GroanKing05/AudioAmplifier/Hardware Oscilloscope Images/Bandpass and Voltage Regulators.jpg

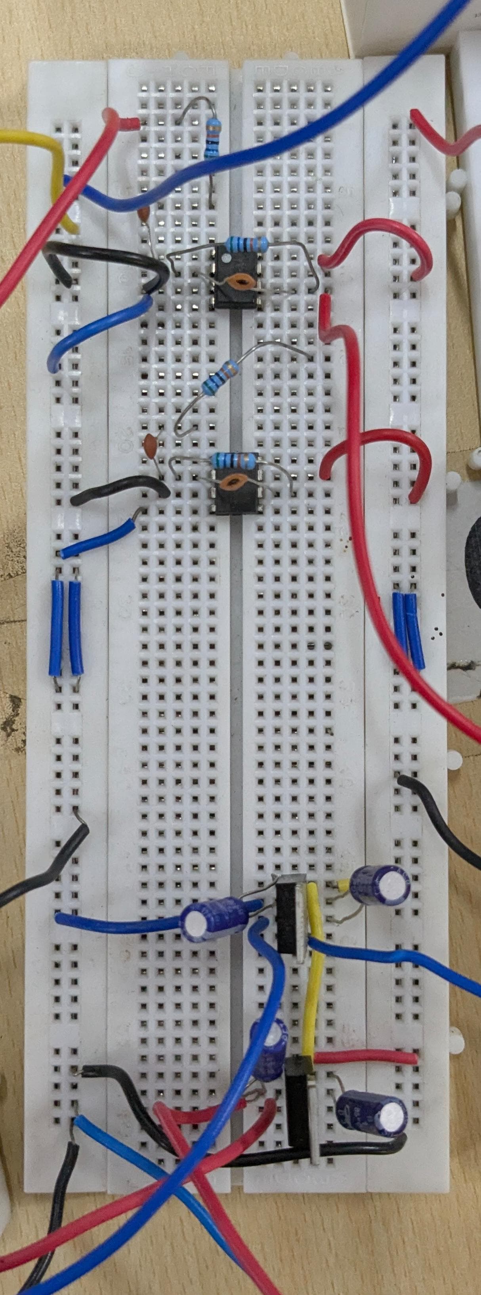
Hardware Oscilloscope Images/Bandpass and Voltage Regulators.jpg
