GroanKing05/AudioAmplifier/Hardware Oscilloscope Images/BP 3dB.png

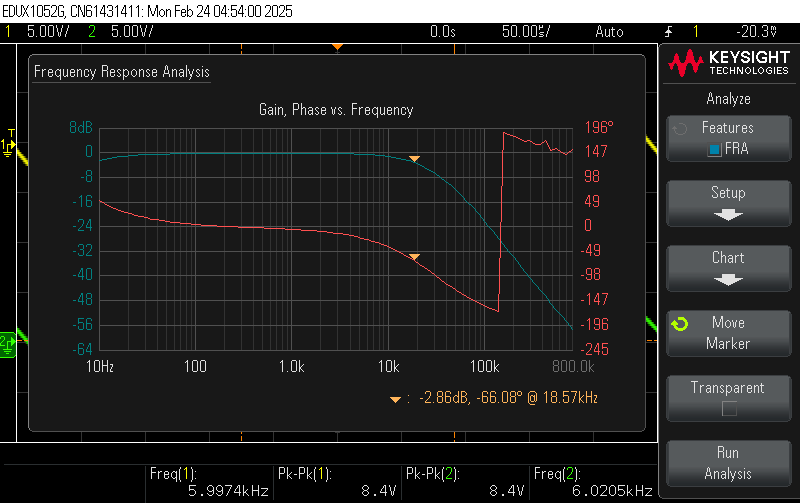
Hardware Oscilloscope Images/BP 3dB.png
