GroanKing05/AudioAmplifier/Hardware Oscilloscope Images/BP midband.png

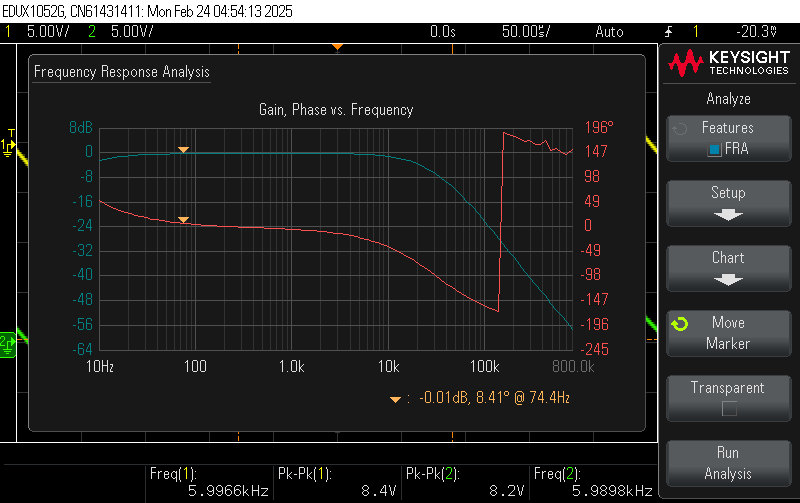
Hardware Oscilloscope Images/BP midband.png
