GroanKing05/AudioAmplifier/Hardware Oscilloscope Images/FFT 1k4k.png

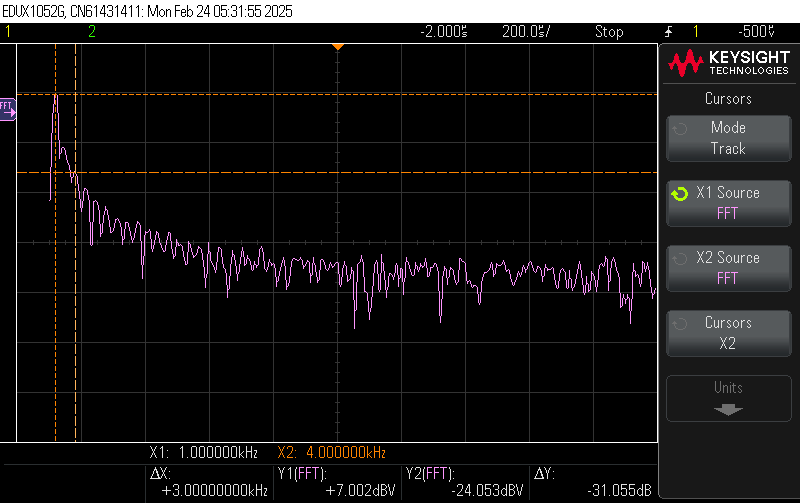
Hardware Oscilloscope Images/FFT 1k4k.png
