GroanKing05/AudioAmplifier/Hardware Oscilloscope Images/FFT with Voltages.png

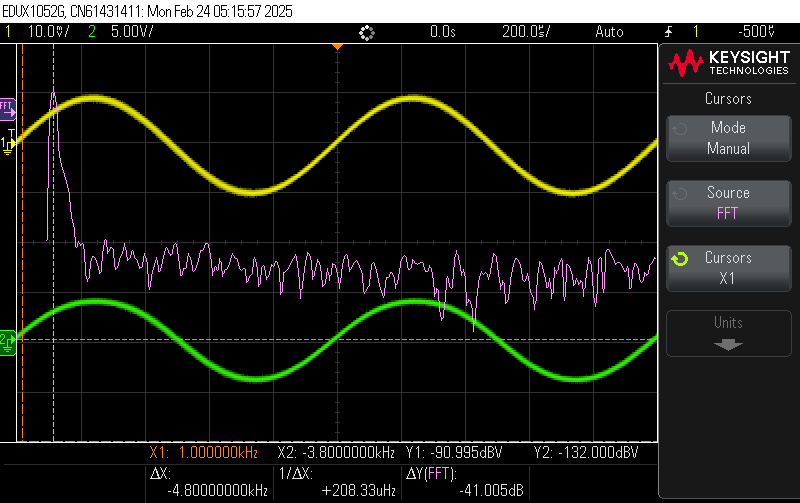
Hardware Oscilloscope Images/FFT with Voltages.png
