GroanKing05/AudioAmplifier/Hardware Oscilloscope Images/Final Bode Midband.png

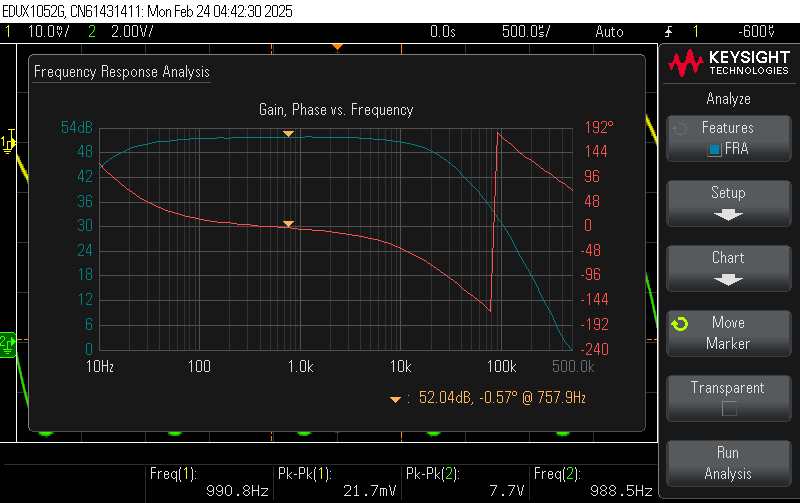
Hardware Oscilloscope Images/Final Bode Midband.png
