GroanKing05/AudioAmplifier/Hardware Oscilloscope Images/Final Voltages.png

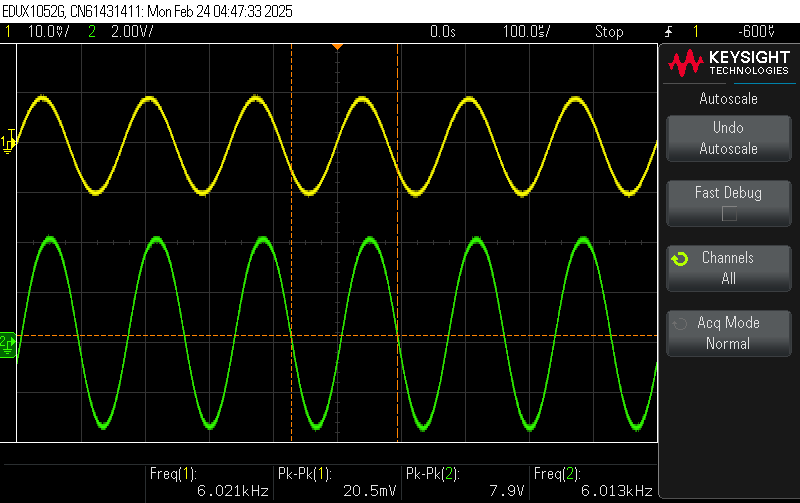
Hardware Oscilloscope Images/Final Voltages.png
