GroanKing05/AudioAmplifier/Hardware Oscilloscope Images/FinalBode Higher3db.png

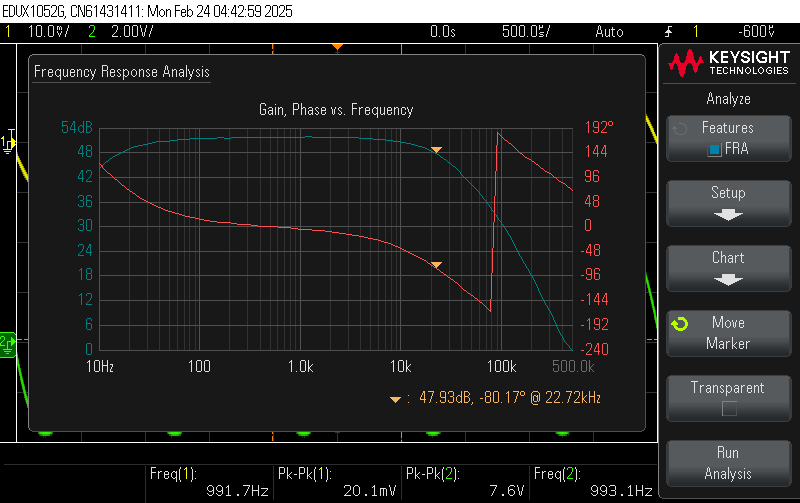
Hardware Oscilloscope Images/FinalBode Higher3db.png
