GroanKing05/AudioAmplifier/Hardware Oscilloscope Images/Full Voltages.png

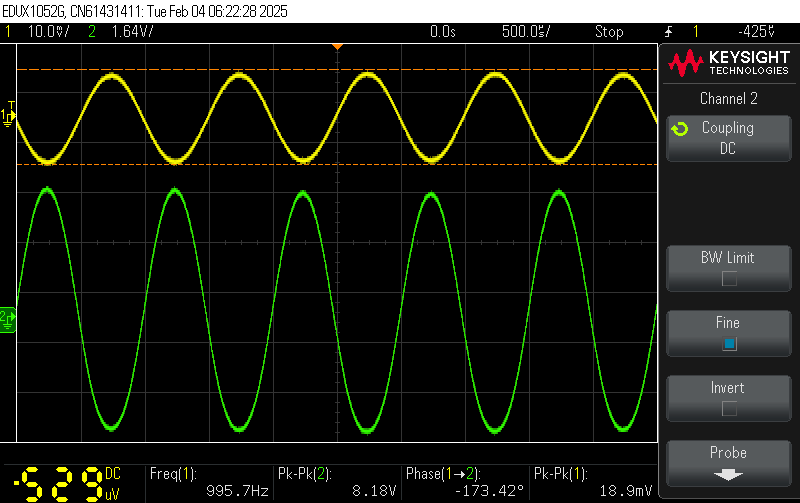
Hardware Oscilloscope Images/Full Voltages.png
