GroanKing05/AudioAmplifier/Hardware Oscilloscope Images/Labelled BP VoltageRegs.png

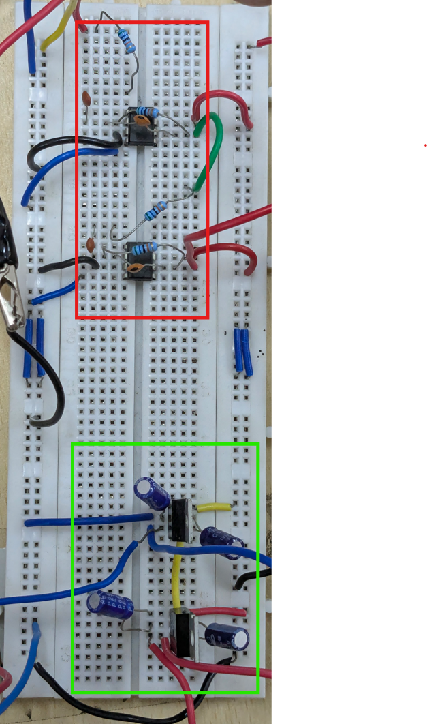
Hardware Oscilloscope Images/Labelled BP VoltageRegs.png
