GroanKing05/AudioAmplifier/Hardware Oscilloscope Images/Labelled Gain Preamp Amp.png

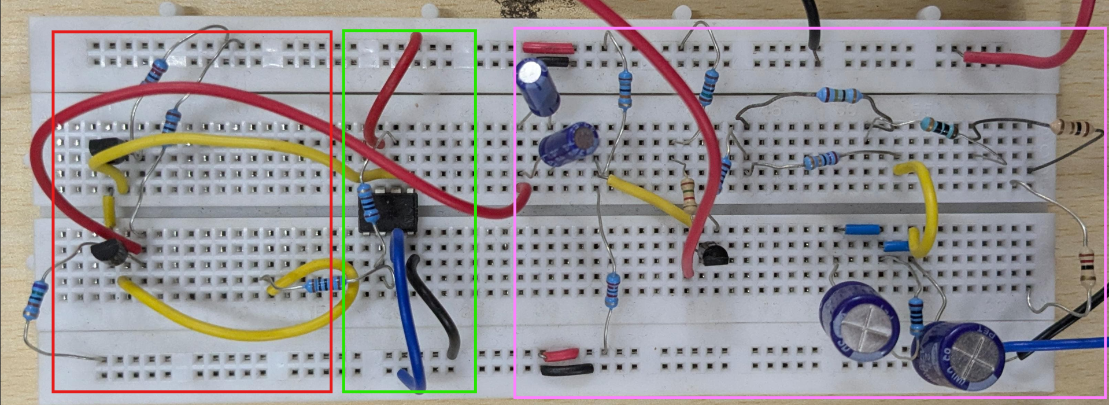
Hardware Oscilloscope Images/Labelled Gain Preamp Amp.png
