GroanKing05/AudioAmplifier/Hardware Oscilloscope Images/Power Amp.jpg

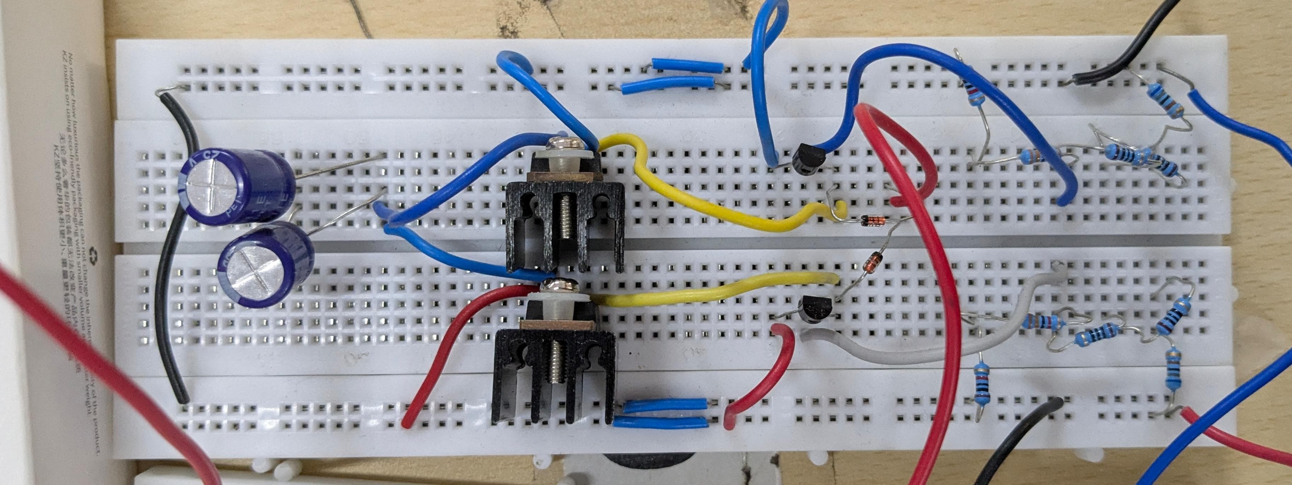
Hardware Oscilloscope Images/Power Amp.jpg
