GroanKing05/AudioAmplifier/Hardware Oscilloscope Images/Power Amplifier.jpg

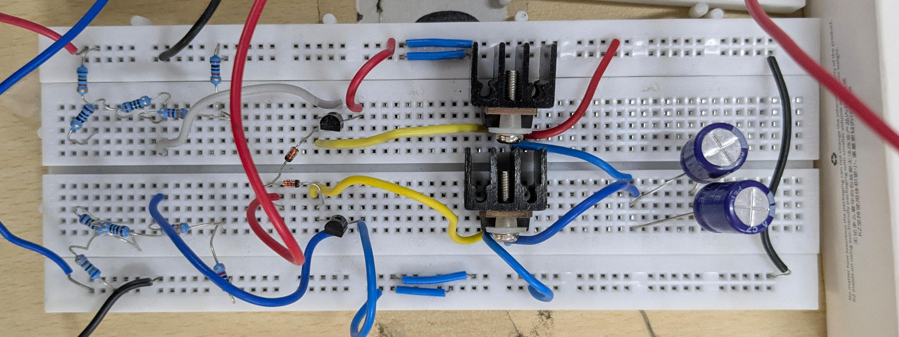
Hardware Oscilloscope Images/Power Amplifier.jpg
