GroanKing05/AudioAmplifier/Hardware Oscilloscope Images/PowerAmp FRA.png

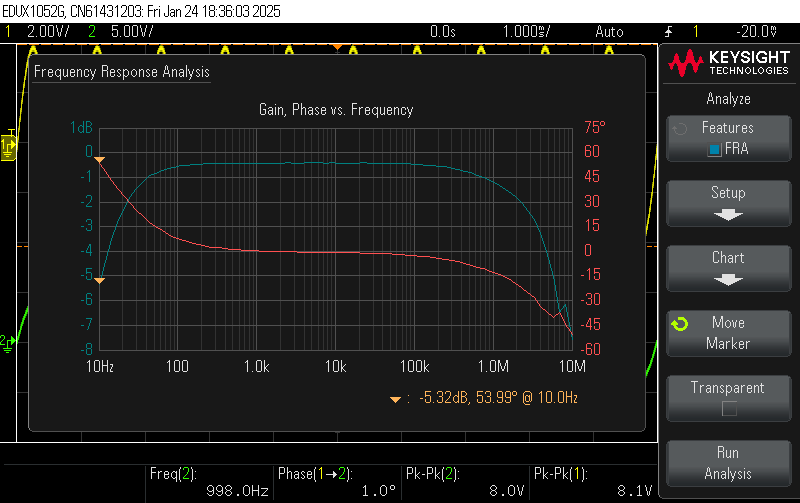
Hardware Oscilloscope Images/PowerAmp FRA.png
