GroanKing05/AudioAmplifier/Hardware Oscilloscope Images/PowerAmp Waveforms.png

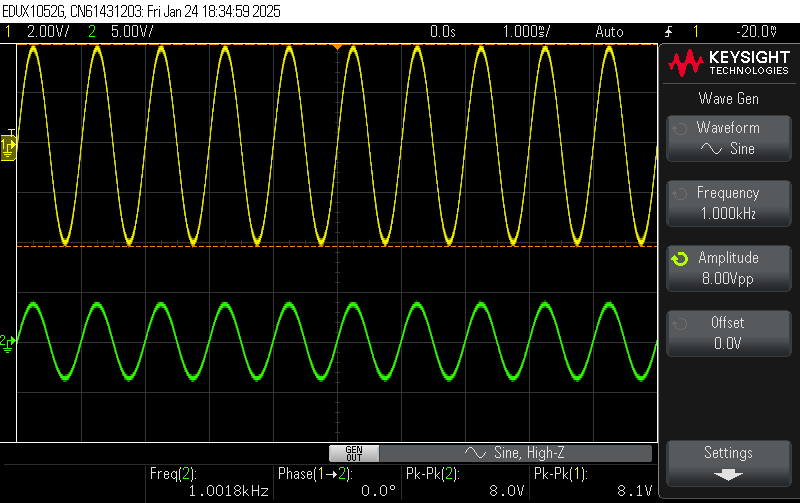
Hardware Oscilloscope Images/PowerAmp Waveforms.png
