GroanKing05/AudioAmplifier/Hardware Oscilloscope Images/Preamp and Gain stage.jpg

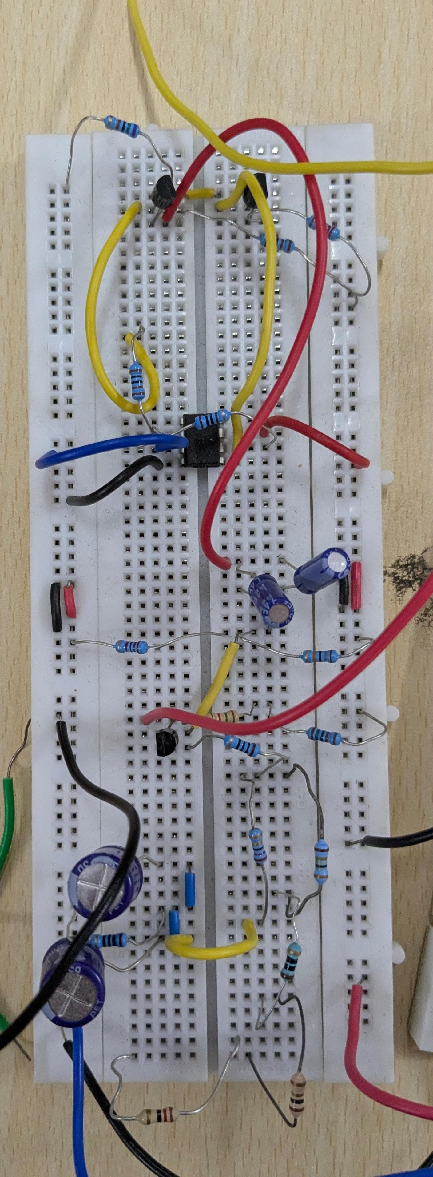
Hardware Oscilloscope Images/Preamp and Gain stage.jpg
