GroanKing05/AudioAmplifier/Hardware Oscilloscope Images/Preamp Bode.png

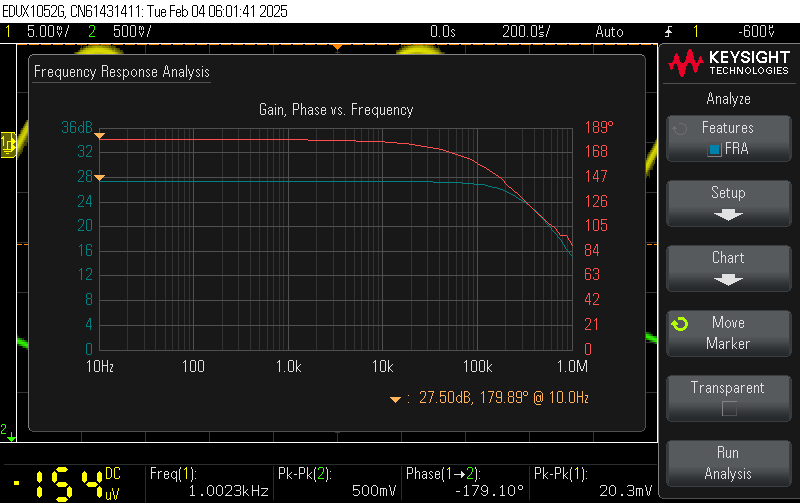
Hardware Oscilloscope Images/Preamp Bode.png
