GroanKing05/AudioAmplifier/Hardware Oscilloscope Images/Preamp Gain Bode.png

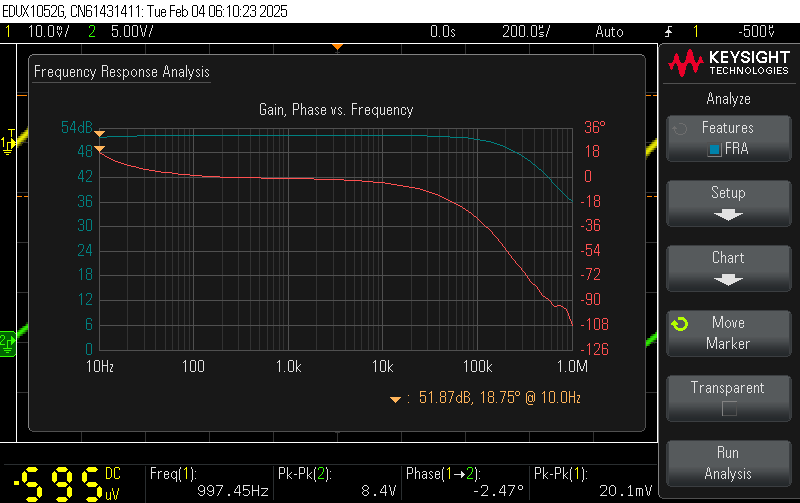
Hardware Oscilloscope Images/Preamp Gain Bode.png
