GroanKing05/AudioAmplifier/Hardware Oscilloscope Images/Preamp Gain voltages with full ckt.png

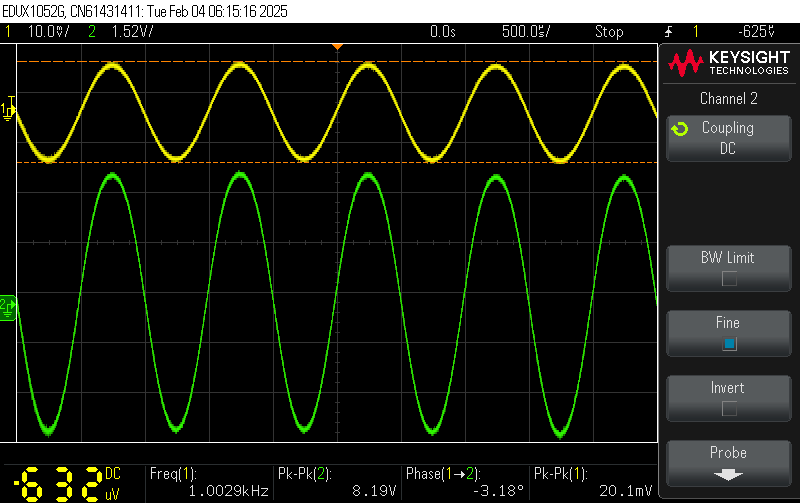
Hardware Oscilloscope Images/Preamp Gain voltages with full ckt.png
