GroanKing05/AudioAmplifier/Hardware Oscilloscope Images/Preamp Gain Voltages.png

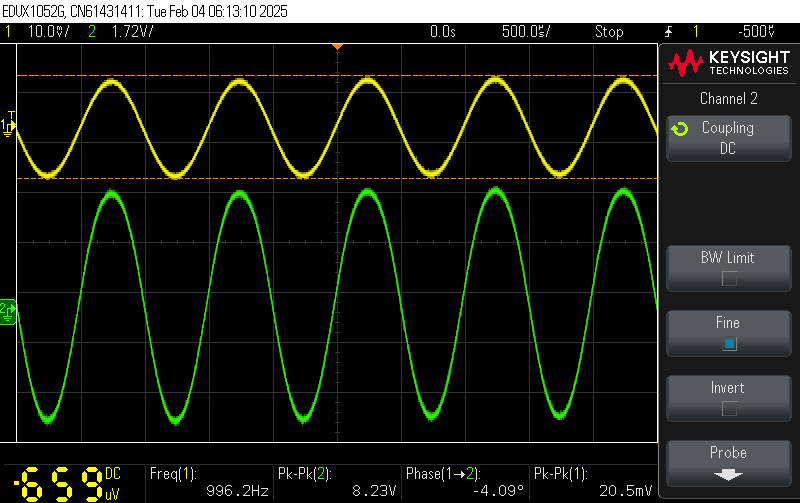
Hardware Oscilloscope Images/Preamp Gain Voltages.png
