GroanKing05/AudioAmplifier/Hardware Oscilloscope Images/Preamp Voltages full ckt.png

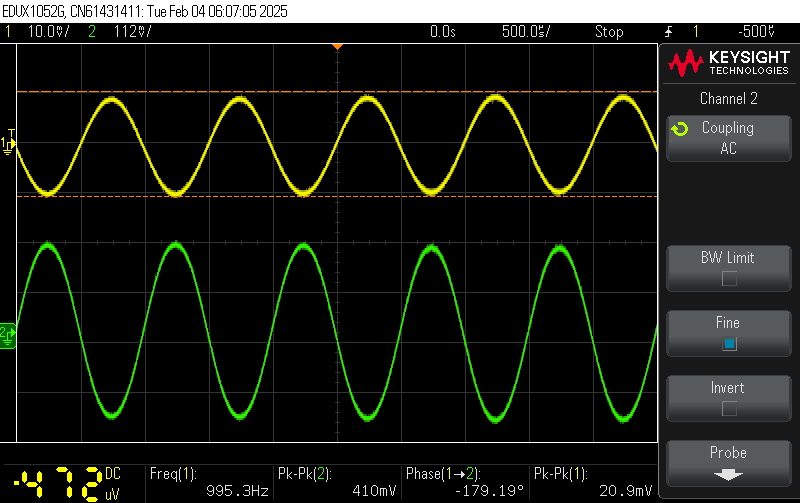
Hardware Oscilloscope Images/Preamp Voltages full ckt.png
