GroanKing05/AudioAmplifier/Preamp Stage/Preamp_Final.asc

C1: cap; 1p
Q1: npn; BC547B
Q2: npn; BC547B
R1: res; 2.3k
R2: res; 2.3k
R3: res; 7.5k
V1: voltage; SINE(0 10m 1k)
V2: voltage; SINE(0 10m 1k 0 0 180)
V5: voltage; 5
V6: voltage; 5
Named nets: 0, Vin, Vin_inv, Ve, VCC, -VEE, Vo
.tran 10m
.ac dec 1k 1 1G
.four 1000 4 -1 V(Vo)
.four 1000 4 -1 V(Vo)
