GroanKing05/AudioAmplifier/Filter Stage/Filter_Final.asc

C1: cap; 47nF
C2: cap; 7.2pF
C3: cap; 47nF
C4: cap; 7.2pF
R1: res; 560k
R2: res; 560k
R3: res; 560k
R4: res; 560k
U1: opamp2; UA741
U2: opamp2; UA741
V1: voltage; 5
V2: voltage; 5
V3: voltage; ""; AC 1
Named nets: VCC, 0, -VEE, Vo
.ac dec 1000 1 1G
.inc "C:\\Users\\varun\\Documents\\IIITH\\Sem4\\EW2\\UA741.301"
