GroanKing05/AudioAmplifier/Final_SubmissionTeam6/Full_Circuit.asc

C1: cap; 3µ
C2: cap; 800µF
C3: cap; 940µ
C4: cap; 47nF
C5: cap; 5pF
C6: cap; 5pF
C7: cap; 47nF
D1: diode; 1N4148
D2: diode; 1N4148
Q1: npn; BC547B
Q2: npn; BC547B
Q3: npn; BC547B
Q4: npn; TIP31C
Q5: pnp; TIP32C
Q6: pnp; BC557B
Q7: npn; BC547B
R1: res; 3k
R2: res; 100
R3: res; 175k
R4: res; 22k
R5: res; 560k
R6: res; 125
R7: res; 2.3k
R8: res; 2.3k
R9: res; 7.5k
R10: res; 10
R11: res; 1k
R12: res; 1k
R13: res; 560k
R14: res; 560k
R15: res; 560k
U1: opamp2; UA741
U2: opamp2; UA741
U3: opamp2; UA741
V2: voltage; 5
V3: voltage; 5
V4: voltage; SINE(0 10m 1k)
V5: voltage; 0.7
V6: voltage; 12
V7: voltage; 12
V8: voltage; 0.7
Named nets: Vout, Vin, Vin_inv, Ve, 0, VCC5, -VEE5, VCC12, -VEE12, Vin_pwr, Vout_diff, Vout_gain, Vo
.dc V1 1u 12V 0.01
.four 1000 4 -1 V(Vout_diff)
.op
.tran 20m
.ac dec 1000 1 1G
.inc "E:\\OneDrive_1_1-1-2025\\24-25 spring\\Electronic Workshop - 2\\UA741.301"
,inc "C:\\Users\\varun\\Documents\\IIITH\\Sem4\\EW2\\Project1\\Libraries\\UA741.301"
.four 1000 4 -1 V(Vin_pwr)
,inc "C:\\Users\\varun\\Documents\\IIITH\\Sem4\\EW2\\Project1\\Libraries\\tip32c.lib"
,inc "C:\\Users\\varun\\Documents\\IIITH\\Sem4\\EW2\\Project1\\Libraries\\tip31c.lib"
