GroanKing05/AudioAmplifier/Final_SubmissionTeam6/Preamp_Stage.asc

C1: cap; 1p
Q1: npn; BC547B
Q2: npn; BC547B
R1: res; 2.3k
R2: res; 2.3k
R3: res; 7.5k
R4: res; 1k
R5: res; 1k
U1: opamp2; UA741
V1: voltage; 12
V2: voltage; 12
V3: voltage; SINE(0 5m 1k); AC 1
V5: voltage; 5
V6: voltage; 5
Named nets: Vin, Vin_inv, Ve, 0, VCC, -VEE, Vo, -VEE12, VCC12
.tran 10m
.ac dec 1k 1 1G
.four 1000 4 -1 V(Vo)
.four 1000 4 -1 V(Vo)
.inc "C:\\Users\\varun\\Documents\\IIITH\\Sem4\\EW2\\UA741.301"
