GroanKing05/AudioAmplifier/PowerAmp Stage/PowerAmp_5.asc

C1: cap; 940µ
D1: diode; 1N4148
D2: diode; 1N4148
Q1: npn; Qtip31a
Q2: pnp; Qtip32a
Q3: pnp; BC557B
Q4: npn; BC547B
R1: res; 10
V1: voltage; 5
V2: voltage; 5
V3: voltage; SINE(0 4.3 1k); AC 1
V4: voltage; 0.7
V5: voltage; 0.7
Named nets: 0, Vo, VCC, -VEE, Vin
.tran 10m
.inc "C:\\Users\\varun\\Documents\\IIITH\\Sem4\\EW2\\Qtip32a.lib"
.inc "C:\\Users\\varun\\Documents\\IIITH\\Sem4\\EW2\\Qtip31a.lib"
.ac dec 1000 1m 1G
.op
.four 1000 4 -1 V(Vo)
.op
