GroanKing05/AudioAmplifier/Final_SubmissionTeam6/Final_Gain_Stage.asc

C1: cap; 4µ
C2: cap; 800µ
Q1: npn; BC547B
R1: res; 3k
R2: res; 100
R3: res; 175k
R4: res; 22k
R6: res; 125
V1: voltage; SINE(0 210m 1k); AC 1
Vcc1: voltage; 10
Named nets: 0, Vin, Vout
.tran 0 12m 1u
.ac dec 1m 10m 1G
.dc V1 1u 12V 0.01
.four 1000 4 -1 V(vout)
.op
