GroanKing05/AudioAmplifier/Gain Stage/Theoritical Gain.asc

C1: cap; 3.498µ
C2: cap; 763.445µ
Q1: npn; BC547B
R1: res; 3k
R2: res; 104.28
R3: res; 176.4k
R4: res; 19.6k
R6: res; 131.04
V1: voltage; SINE(0 210m 1k)
Vcc1: voltage; 10
Named nets: 0, Vin, Vout
.tran 0 12m 1u
.ac dec 1m 10m 1G
.dc V1 1u 12V 0.01
.four 1000 4 -1 V(vout)
.op
