GroanKing05/AudioAmplifier/Filter Stage/BandPassFilter.asc

C1: cap; 0.1µF
C2: cap; 25pF
R1: res; 150k
R2: res; 150k
U1: opamp2; UA741
V1: voltage; 12
V2: voltage; 12
V3: voltage; ""; AC 1
Named nets: VCC, 0, -VEE, Vout
.ac dec 1000 1 1G
.inc "C:\\Users\\varun\\Documents\\IIITH\\Sem4\\EW2\\UA741.301"
.tran 10m
