GroanKing05/AudioAmplifier/PowerAmp Stage/Darlington.asc

C1: cap; 10µ
C2: cap; 220µF
Q1: npn; TIP31A
Q2: npn; TIP31A
R1: res; 50k
R2: res; 50k
R3: res; 2
R4: res; 10
V1: voltage; 10
V2: voltage; 5
V3: voltage; SINE(0 2.5 1k)
Named nets: VCC, 0, -VEE, Speaker
.inc "C:\\Users\\varun\\Documents\\IIITH\\Sem4\\EW2\\tip31a.lib"
.tran 10m
.four 1000 4 -1 V(speaker)
