GroanKing05/AudioAmplifier/PowerAmp Stage/PowerAmp_1.asc

Cout: cap; 940µ
D1: diode; 1N4148
D2: diode; 1N4148
Q1: npn; TIP31A
Q2: pnp; TIP32
R1: res; 220
R2: res; 220
R3: res; 100
speaker: res; 10
V4: voltage; 5
V5: voltage; 5
Vin: voltage; SINE(0 1.8 1k)
Named nets: 0, Vo, VCC, -VEE, Vd
.tran 20m
.inc "C:\\Users\\varun\\Documents\\IIITH\\Sem4\\EW2\\tip32a.lib"
.inc "C:\\Users\\varun\\Documents\\IIITH\\Sem4\\EW2\\tip31a.lib"
.ac dec 1000 1m 1G
.ac dec 1000 1 1G
.inc "C:\\Users\\varun\\Documents\\IIITH\\Sem4\\EW2\\UA741.301"
.op
.four 1000 4 -1 V(Vo)
3.6V is good
