GroanKing05/AudioAmplifier/PowerAmp Stage/PowerAmp_2.asc

C2: cap; 940µ
D1: diode; 1N4148
D2: diode; 1N4148
Q1: npn; TIP31A
Q2: pnp; TIP32
R1: res; 330
R2: res; 330
R4: res; 10
V1: voltage; SINE(0 3.2 1k)
V2: voltage; 5
V3: voltage; 5
Named nets: 0, Vo, VCC, -VEE, Vin
.tran 10m
.inc "C:\\Users\\varun\\Documents\\IIITH\\Sem4\\EW2\\tip32a.lib"
.inc "C:\\Users\\varun\\Documents\\IIITH\\Sem4\\EW2\\tip31a.lib"
.ac dec 1000 1m 1G
.op
.four 1000 4 -1 V(Vo)
