GroanKing05/AudioAmplifier/PowerAmp Stage/PowerAmp_3.asc

C1: cap; 48µF
C2: cap; 940µ
C3: cap; 48µF
D1: diode; 1N4148
D2: diode; 1N4148
Q1: npn; TIP31A
Q2: pnp; TIP32
R1: res; 330
R2: res; 1k
R4: res; {LOAD}
V1: voltage; SINE(0 4 1k)
V2: voltage; 5
V3: voltage; 5
Named nets: 0, Vo, VCC, -VEE
.tran 10m
.inc "C:\\Users\\varun\\Documents\\IIITH\\Sem4\\EW2\\tip32a.lib"
.inc "C:\\Users\\varun\\Documents\\IIITH\\Sem4\\EW2\\tip31a.lib"
.ac dec 1000 1m 1G
.op
.four 1000 4 -1 V(Vo)
.param LOAD = 10
