GroanKing05/AudioAmplifier/PowerAmp Stage/PowerAmp_4.asc

C2: cap; 940µ
D1: diode; 1N4148
D2: diode; 1N4148
I1: current; 10m
I2: current; 10m
Q3: npn; TIP31A
Q4: pnp; TIP32
R6: res; 10
V5: voltage; 5
V6: voltage; 5
V7: voltage; SINE(0 4.7 1k)
Named nets: 0, Vo, VCC, -VEE, Vin
.tran 10m
.inc "C:\\Users\\varun\\Documents\\IIITH\\Sem4\\EW2\\tip32a.lib"
.inc "C:\\Users\\varun\\Documents\\IIITH\\Sem4\\EW2\\tip31a.lib"
.ac dec 1000 1m 1G
.op
.four 1000 4 -1 V(Vo)
