GroanKing05/AudioAmplifier/Preamp Stage/Preamp_3.asc

C1: cap; 1p
Q1: npn; BC547B
Q2: npn; BC547B
R1: res; 2k
R2: res; 2k
R3: res; 7.5k
V1: voltage; 5
V2: voltage; 5
V3: voltage; SINE(0 10m 1k)
V4: voltage; SINE(0 10m 1k 0 0 180)
Named nets: 0, Vin, Vin_inv, Ve, VCC, -VEE, Vo
.tran 10m
.ac dec 1k 1 1G
.four 1000 4 -1 V(Vo)
.four 1000 4 -1 V(Vo)
