GroanKing05/AudioAmplifier/(commit log)

2025-01-12 Adding Filter, Preamp and the Power amp stages.
2025-01-12 Adding final circuit
2025-01-16 Adding Final Circuit and the Bill of Materials
2025-01-16 gain stage
2025-01-17 Changes in Final Circuit and Bill of Materials
2025-01-17 Changes in Final Circuit
2025-01-17 Adding Power Amp Topologies
2025-01-24 Adding Images of Power Amplifier
2025-03-04 Power Amplifier file renames
2025-03-04 Added Full Circuit in README
